nichclark/teamNACHO/PCBdesign/teamNACHOrev2.brd

## EAGLE design PCBdesign/teamNACHOrev2.brd (2015-12-08)

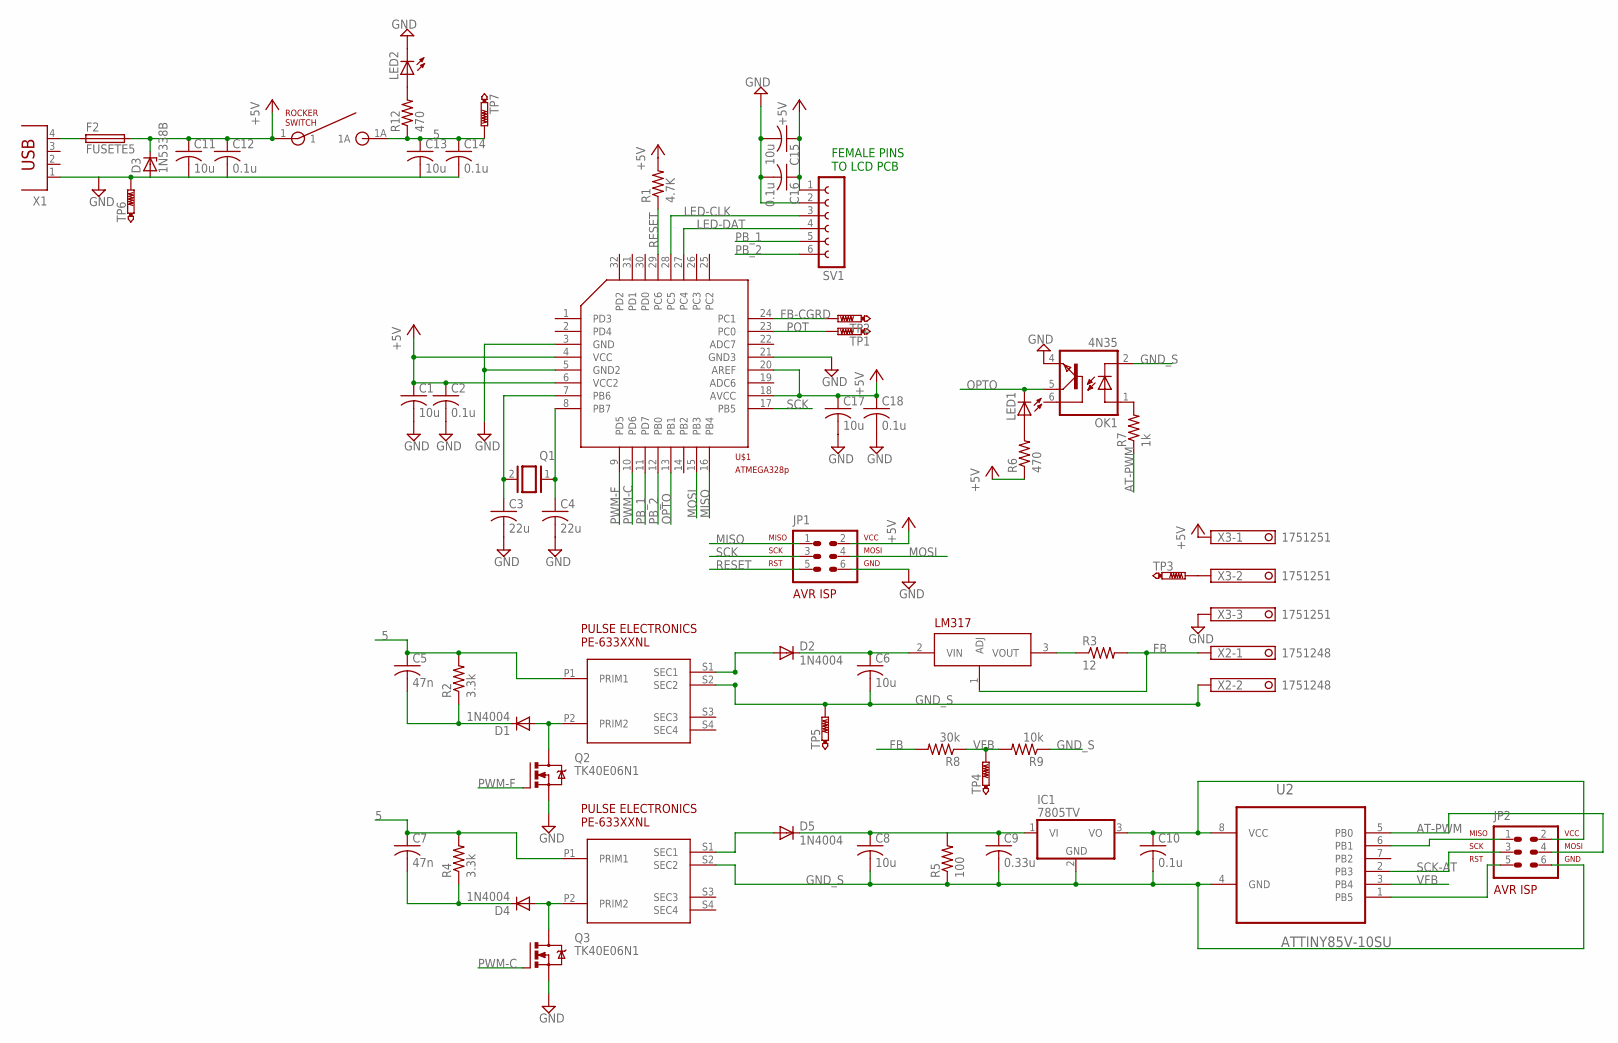
[picture p1: schematic teamNACHOrev2.sch]

Parts:
C1, C6, C8, C11, C13, C15, C17: 10u; C0805
C2, C10, C12, C14, C16, C18: 0.1u; C0805
C3, C4: 22u; C0805
C5, C7: 47n; C0805
C9: 0.33u; C0805
D1, D2, D4, D5: 1N4004; DO41-10
D3: 1N5338B; C1702-15
F2: FUSETE5; TE5
IC1: 7805TV; TO220V
JP1, JP2: AVR-ISP-6VERT; AVR-ISP-6
LED1, LED2: LED_ELD260; LED_LD260
OK1: 4N35; DIL06
Q1: XTAL/S; QS
Q2, Q3: TK40E06N1; TO220BV
R1: 4.7K; R0805
R2, R4: 3.3k; R0805
R3: 12; M0805
R5: 100; R0805
R6, R12: 470; M0805
R7: 1k; M0805
R8: 30k; R0805
R9: 10k; R0805
SV1: FE06-1; FE06
TP1, TP2, TP3, TP4, TP5, TP6, TP7: PTR1PAD1-20; P1-20
U2: ATTINY85V-10SU; SOIC127P798X216-8N
U$1: ATMEGA328P; TQFP32
U$2, U$5: PE-63388NL; PE-633XXNL
U$3: LM317; TO220V
U$4: COM-08837; ROCKERSWITCH
X1: PN87520
X2: 1751248
X3: 1751251

Connections:
5: C5.1, C7.1, C13.1, C14.1, R2.2, R4.2, R12.1, TP7.TP, U$2.P1 (PRIM1), U$4.1A, U$5.P1 (PRIM1)
+5V: C1.1, C2.1, C11.1, C12.1, C15.1, C16.1, C17.1, C18.1, D3.C, F2.2, JP1.2, R1.2, R6.1, SV1.1, U$1.4 (VCC), U$1.6 (VCC2), U$1.18 (AVCC), U$1.20 (AREF), U$4.1, X3.1
AT-PWM: JP2.4, R7.1, U2.5 (PB0)
FB: R3.2, R8.2, U$3.1 (ADJ), X2.1
FB-CGRD: TP2.TP, U$1.24 (PC1)
GND: C1.2, C2.2, C3.2, C4.2, C11.2, C12.2, C13.2, C14.2, C15.2, C16.2, C17.2, C18.2, D3.A, JP1.6, LED2.K (C), OK1.4 (EMI), Q2.S, Q3.S, SV1.2, TP6.TP, U$1.3 (GND), U$1.5 (GND2), U$1.21 (GND3), X1.1, X3.3
GND_S: C6.2, C8.2, C9.2, C10.2, IC1.2 (GND), JP2.6, OK1.2 (C), R5.1, R9.1, TP5.TP, U2.4 (GND), U$2.S2 (SEC2), U$5.S2 (SEC2), X2.2
LED-CLK: SV1.3, U$1.28 (PC5)
LED-DAT: SV1.4, U$1.27 (PC4)
MISO: JP1.1, U$1.16 (PB4)
MOSI: JP1.4, U$1.15 (PB3)
unnamed: C5.2, D1.C, R2.1
unnamed: C3.1, Q1.2, U$1.7 (PB6)
unnamed: C4.1, Q1.1, U$1.8 (PB7)
unnamed: D1.A, Q2.D, U$2.P2 (PRIM2)
unnamed: C8.1, C9.1, D5.C, IC1.1 (VI), R5.2
unnamed: D2.A, U$2.S1 (SEC1)
unnamed: C6.1, D2.C, U$3.2 (VIN)
unnamed: R3.1, U$3.3 (VOUT)
unnamed: LED2.A, R12.2
unnamed: LED1.A, R6.2
unnamed: TP3.TP, X3.2
unnamed: D4.A, Q3.D, U$5.P2 (PRIM2)
unnamed: C7.2, D4.C, R4.1
unnamed: D5.A, U$5.S1 (SEC1)
unnamed: C10.1, IC1.3 (VO), JP2.2, U2.8 (VCC)
unnamed: OK1.1 (A), R7.2
unnamed: JP2.5, U2.1 (PB5)
unnamed: JP2.1, U2.6 (PB1)
unnamed: F2.1, X1.4
OPTO: LED1.K (C), OK1.5 (COL), U$1.13 (PB1)
PB_1: SV1.5, U$1.11 (PD7)
PB_2: SV1.6, U$1.12 (PB0)
POT: TP1.TP, U$1.23 (PC0)
PWM-C: Q3.G, U$1.10 (PD6)
PWM-F: Q2.G, U$1.9 (PD5)
RESET: JP1.5, R1.1, U$1.29 (PC6)
SCK: JP1.3, U$1.17 (PB5)
SCK-AT: JP2.3, U2.2 (PB3)
VFB: R8.1, R9.2, TP4.TP, U2.3 (PB4)

Notes on the sheet:
FEMALE PINS TO LCD PCB

Board: 2 copper layers, 60 parts (26 on the bottom side), 40 nets, no tracks yet.
