nichclark/teamNACHO/PCBdesign/displayPCB.brd

## EAGLE design PCBdesign/displayPCB.brd (2015-11-17)

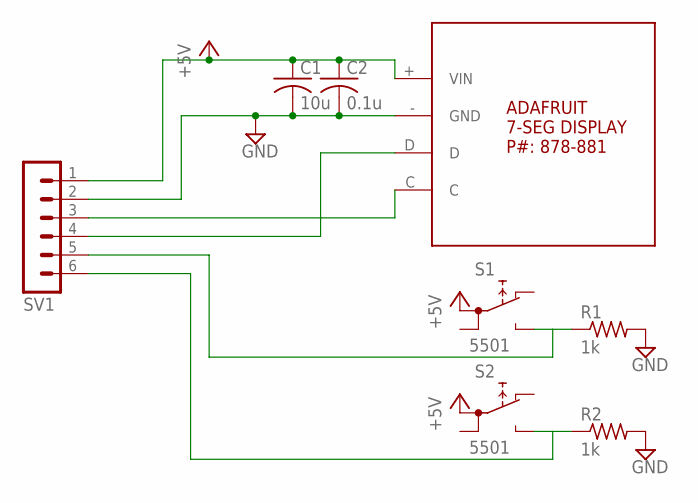
[picture p2: schematic displayPCB.sch]

Parts:
C1: 10u; C0805
C2: 0.1u; C0805
R1, R2: 1k; R0805
S1, S2: 5501
SV1: MA06-1
U$1: AFDISPLAY

Connections:
+5V: C1.1, C2.1, S1.1A, S2.1A, SV1.1, U$1.+ (VIN)
GND: C1.2, C2.2, R1.2, R2.2, SV1.2, U$1.- (GND)
unnamed: SV1.3, U$1.C
unnamed: SV1.4, U$1.D
unnamed: R1.1, S1.NO, SV1.5
unnamed: R2.1, S2.NO, SV1.6

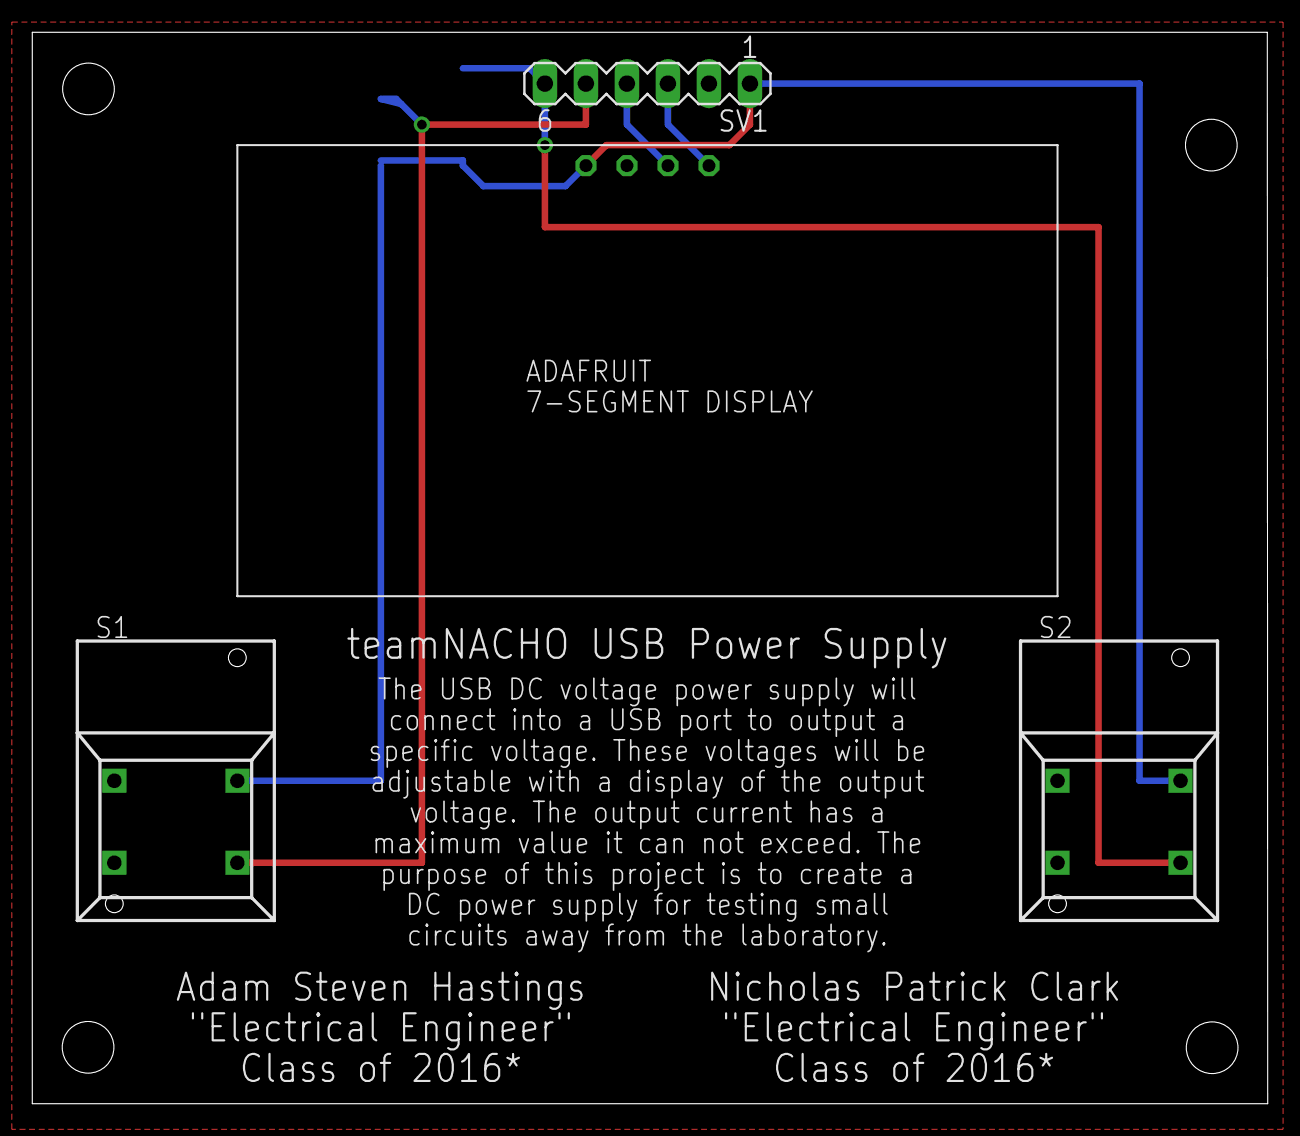
[picture p3: board displayPCB.brd from above]

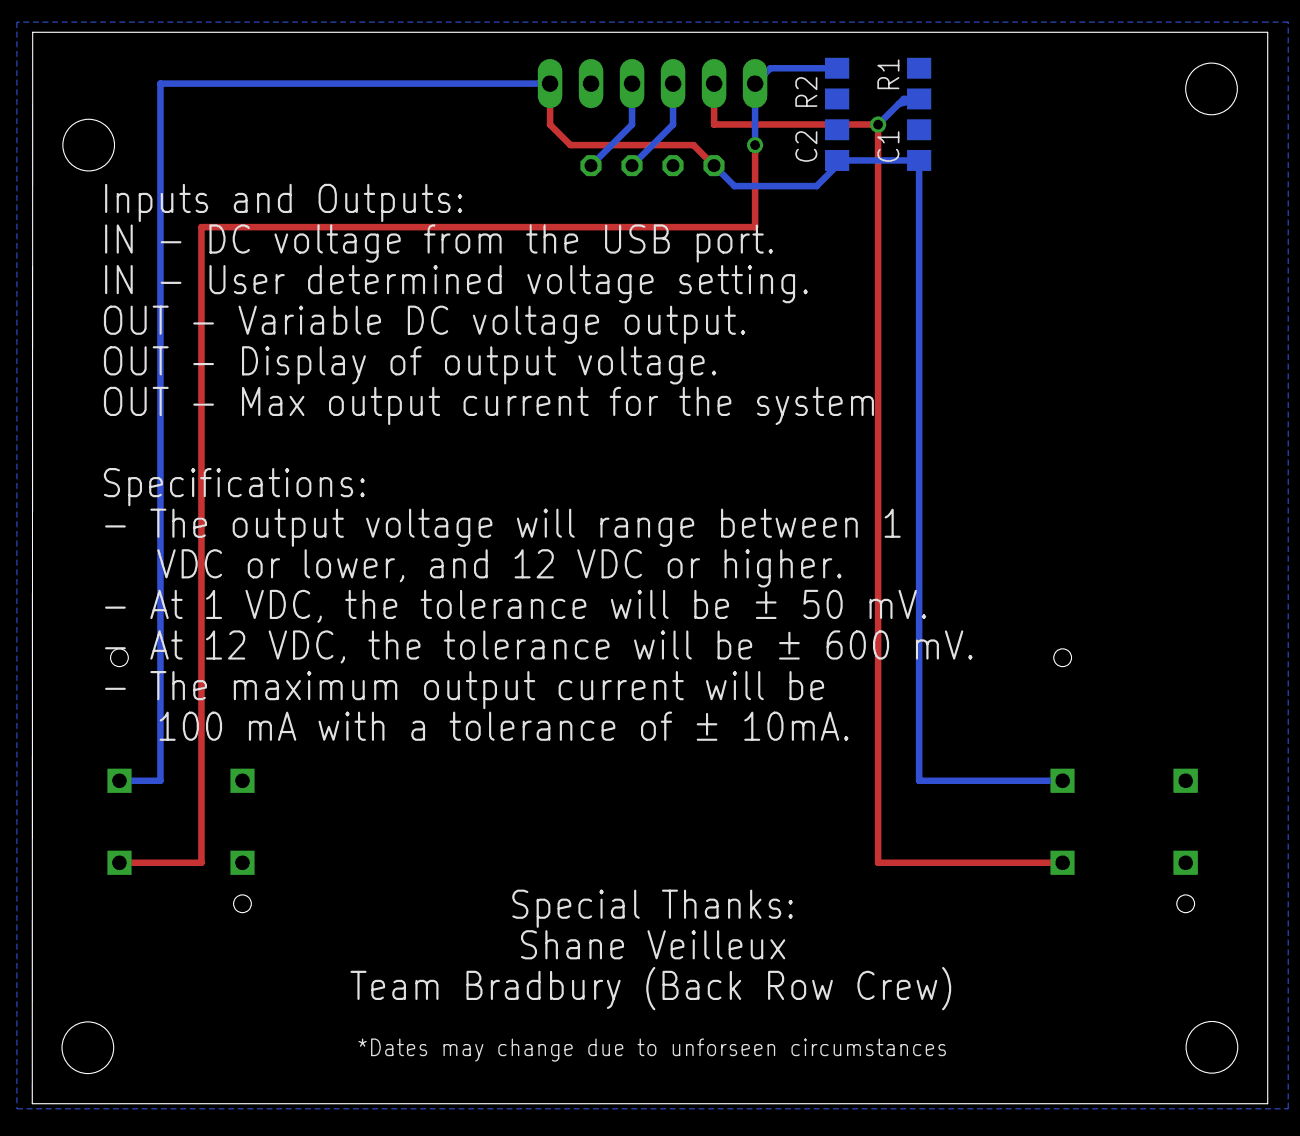
[picture p4: board displayPCB.brd from below]

Board: 2 copper layers, 76.5 x 66.4 mm, 8 parts (4 on the bottom side), 6 nets.
