nichclark/teamNACHO/HeaderFiles/userinput.h

/*
TITLE("TeamNACHO USB Power Supply");
SUBTITLE("User Input Header File");
BY("Adam S. Hastings && Nicholas P. Clark");
DATE("17 December 2015");

This header file declares TeamNACHO's userInput Fxn
*/

#ifndef USERINPUT_H
#define USERINPUT_H

float userInput(int pushbuttA, int pushbuttB);

#endif
