nichclark/teamNACHO/(commit log)

2015-10-23 Initial start to the PID loop
2015-10-23 First attempt at complete PI Loop
    Used code to drive a DC fan. Used a pot to set the desired speed.
2015-10-26 Redid PID loop program, have not tested yet
2015-10-26 Went back to the first PID loop controller, new one wasn't working
2015-10-27 Program Works!!
    At this point, the program is able to drive the circuit. Changed the kP
    and kI values to try to get a steady response, but still not perfect.
    Need to play around with values more. Maybe add a kD term to code?
2015-10-27 Added kD and subroutine
    Move PID loop into subroutine to make main loop simpler. Also added
    derivative term calculations to program. Hopefully this will help reduce
    SSE.
2015-10-29 PID coeffs
    got PID coefficients closer to ideal. this reduced the ripple on the
    output greatly.
2015-11-02 7-seg display
    Started to mess around with 7-seg display, had to download libraries
    from Adafruit to be able to implement with board.
    https://learn.adafruit.com/adafruit-led-backpack/0-dot-56-seven-segment-backpack
2015-11-02 UI for increasing and decreasing output voltage.
    added push buttons to 7-segment display circuit. trying to make the
    segment increment and decrement when either button is pressed.
2015-11-02 button pressed testing
    got the value on the display to increment, debounce doesnt work......
2015-11-02 PCB design Rev1
    Started to do PCB schematic. Got ATmega328p library from Shaun.
    [teamNACHOrev1.sch]
2015-11-03 still working on PB
    got the counter to increment by only 1 each time a button is pressed.
2015-11-03 ATmega
    Believe the initial set up of atmega328p has been done.
    [teamNACHOrev1.sch]
2015-11-03 PB stuff still
    made it so when either button is pressed and held, the other will not
    work.
2015-11-03 Transformer Added
    Created and added the transformer to circuit. Started to create flyback
    circuit.
    [teamNACHOrev1.sch]
2015-11-03 push and hold PB
    got the buttons to increment & decrement by 1 with one press and
    increment/decrement rapidly with a hold.
2015-11-04 Slowly but surely
    Slowly adding more components to schematic. still not sure how to do
    atmega correctly
    [teamNACHOrev1.sch]
2015-11-04 PCB Board Layout
    Started to lay out the board
    [teamNACHOrev1.brd]
2015-11-04 Fixed USB
    Flipped which pins on USB are ground and power. Also may have to make
    own lib for LM317, they don’t have the correct pcb package we need.
    [teamNACHOrev1.brd, teamNACHOrev1.sch]
2015-11-04 Cleaned Up Code
    Created subroutines so that one routine controls PB logic and
    incrementing a value. A limit of the value was created to represent the
    limits of our circuits capabilities. The other subroutine then posts the
    value to the display. To get the decimal, a colon was used. To actually
    get the decimal, we are going to have to do a lot more programming, may
    not be worth it to us to do.
2015-11-04 Tried using PBs
    Not sucessfull, can't convert display number into ADC range properly
2015-11-09 ATtiny Program
    Decided to use an ATtiny85 to take the output voltage and create a
    signal. The signal will pass through an opto. This will allow us to have
    isolation between the two sides of the circuit. Right now it takes the
    voltage to control a duty cycle, may have it control frequency instead?
    Not sure yet.
2015-11-09 added reading PWM duty cycle
    was able to read the duty cycle that was being output from the
    optocoupler. getting close to isolation!!!!!!!!!!!!!!!
2015-11-12 PCB design Rev 1
2015-11-13 hur ya go
    asdfasdf
    [teamNACHOrev1.brd, teamNACHOrev1.sch]
2015-11-13 HERE YOU GO ADAM
    [teamNACHOrev1.brd, teamNACHOrev1.sch]
2015-11-16 Done with PCB Rev1 for Power Supply and Display PCB
    [displayPCB.brd, displayPCB.sch, teamNACHOrev1.brd, teamNACHOrev1.sch]
2015-11-17 trying to get font to fit
    [displayPCB.brd]
2015-11-17 designPCB complete
    PCB complete and uploaded to OSHpark for ordering
    [displayPCB.brd]
2015-12-04 Didn't realize we can make revs on this........
    Well fuck
    [FlybackControllerRev1.ino]
2015-12-04 PCB Program
    This program is the program that will be/is on the PCB. It has the
    correct pins for the atmega328p
    [FlybackControllerPCB.ino]
2015-12-05 Created a C-Grade program
    Since PCB is not working, created a new file that will be used strictly
    for the C-grade circuit. The program has bare minimums to get circuit
    to meet teachers expectations. So far, have fixed the PID loop
    interrupt issue. However, PID loop is not working, for some reason it
    is just taking the calculated Error and setting that as the output duty
    cycle.
2015-12-06 Got PID controller to Work at 1V
    Was able to get PID constants to work at 1V. Decided that to meet
    contract spec, will need to have different sets of PID constants for
    the range of output voltages circuit can reach. That is the next step.
2015-12-06 PID Controller Constants
    Now have a set of constants that will work at 1V and 5V. For some
    reason when I try to get up to 12V, the program gets stuck at the max
    duty cycle allowed. Also have to hit reset button every time load
    resistor is changed, output is not going back down to zero.
2015-12-06 Progress
    Still trying to figure out coeffs for 12V. Think that code will work
    better when PBs are used instead of pot
2015-12-06 Don't need the D
    Realized that the D term was screwing up the code. Was able to get 12V
    now. However, now can’t get 1V
2015-12-06 May have solved issue
    When I had issues before, was using a load resistor of 5kohm. Replaced
    with a 200ohm and was able to get regulated voltage at 1V and 12V.
    Think this means we need to determine what the max and min load we can
    drive.
2015-12-07 Above and Beyond Circuit
    This program will be used for above&beyond perf board circuit.
2015-12-07 Feedback
    This header file reads a digital pin and determines what the duty cycle
    is. This is how the feedback of the output voltage is determined
2015-12-07 User Input
    This header file uses the PBs to determine what the user desired output
    voltage will be
2015-12-07 PID control
    This header file gets passed the variables for the PID loop. It also is
    the code from the CGrade program.
2015-12-08 Most of the way done
    At this point, all of the necessary code is in header files that are
    being included. Also have changed to using an interrupt fxn to run the
    PID loop instead of trying to do it on our own. As of right now, the
    PID loop, initializations, feedback calc, and user input are in their
    own header files. Writing to the display had to be done as a subroutine
    as a matrix had to be declared. The initializations and writing to
    display had to be in the same program as two matrixes could not be
    declared.
2015-12-08 New Inits
    At this point, the clock has been initialized differently. This was due
    to the need to initialize an interrupt. The modes of all the arduino
    pins is also initialized now.
2015-12-08 New PID debug
    Added some extra lines for debugging to serial monitor. Also moved the
    Actual and Desired values to global variables for other header files to
    use.
2015-12-08 New PBs
    Moved the max and min values to global variables for other header files.
    Also had to change how PBs are read as the buttons are normally closed
    instead of normally open. As of right now, not able to get code to work
    properly.
2015-12-08 Changed variable name
    Changed variable name of "feedback" to "Vopto" to lessen confusion.
    Feedback as variables was being used too much in code.
    [feedback.cpp, feedback.h]
2015-12-08 Don't need anymore
    Don't need header file anymore since matrix had to be declared in main
    code. However, was able to get decimal to print by calculating what
    digit needed to be displayed for each 7seg. This code is now all in the
    main code.
2015-12-08 Started making a second pcb board just in case
    [teamNACHOrev2.brd, teamNACHOrev2.sch]
2015-12-08 Changed what pin on ATtiny85 reads Vopto
2015-12-10 Had to tell ATtiny what voltage to reference
2015-12-10 Have been using this code to try to debug circuit
2015-12-12 This code will be PCB code for non-isolated grounds
    This has correct pin outs
    [FlybackControllerPCB_C.ino]
2015-12-13 got feed back working
    The feedback was working on another arduino. the problem we were having
    is that the timer was changed in order to produce a 62.5K Hz pwm for the
    mosfets.
    [FeedbackWorking.ino]
2015-12-13 Meshing two PCBs together
    Trying to get the 7seg/PB pcb to work with CGrade circuit pcb. Using a
    desired value that is on 7seg is not working well in PID loop.
    [FlybackControllerPCB_C.ino]
2015-12-14 got feedback PWM to be read.
    read the length in time the feedback signal was low.
2015-12-14 Feedback included with code
    This code now has code to read PWM input to calculate duty cycle. For
    some reason subroutines and header files are not working correctly. As
    of right now, are code is in main loop. Once program works, will try to
    recreate subroutines, get rid of global variables, etc.
    [FlybackControllerABOVE.ino]
2015-12-14 Tried new comparator circuit
    We got the new comparator circuit to work with the arduino powered off
    the same USB as the input power. Also got push buttons to work with the
    PI loop.
2015-12-15 IT WORKS!!!!!!
    Hummels figured out our circuit problem, which made the code way easier
    to measure the duty cycle. Now we are trying to get rid of all the
    global variables and create subroutines. 2 days left.
    [FlybackControllerABOVE.ino]
2015-12-16 Continued moving forward
    Continued to make progress on reorganizing and the PID loop. The PID
    loop is not working correctly at the moment, going to do research and
    try to figure out if better way to calculate terms.
    [FlybackControllerABOVE.ino]
2015-12-16 What comes first, the chicken or the egg?
    Can get the calculate feedback fxn if set duty cycle is on analogWrite.
    Can’t get any readings if use PID loop…must be missing something in the
    code that is creating this issue, maybe a timing issue?
    [FlybackControllerABOVE.ino]
2015-12-16 PID works!
    Adam realized that our max output duty we were allowing was too large,
    it was not letting the circuit discharge fast enough. So we changed the
    max allowable duty cycle from 97% to 78%. Had to pull some terms out of
    the subroutines and make them global variables to make it work.
    [FlybackControllerABOVE.ino]
2015-12-16 PID close to done
    Have got the PID coeffs close to correct. Time to start moving
    subroutines into header files
    [FlybackControllerABOVE.ino]
2015-12-16 PID Header file complete
    Copied subroutine over.
2015-12-16 Forgot to remove the Switch, not using anymore
